gibsjose/MarbleSorter/Board.png

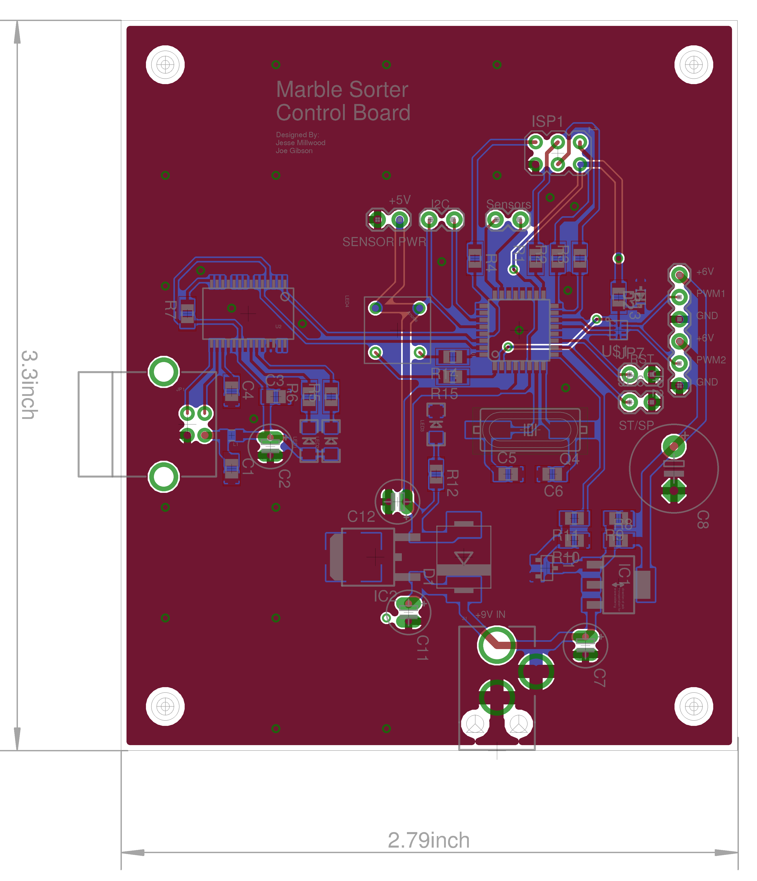
Board.png
