gibsjose/MarbleSorter/IR LED Switching.cir

$ 1 32 0.00390625 0 5 50 White 1024 1024 false

g 352 448 352 512 0
R 352 192 352 128 0 0 1 5 0 0 0.5 
r 352 192 352 256 0 10000
R 576 192 576 128 0 0 1 5 0 0 0.5 
r 576 192 576 256 0 180
w 352 256 352 320 0
w 352 320 352 384 0
w 576 288 576 256 0
162 576 384 576 448 1 1.2 1 0.1 0.1
g 576 448 576 512 0
w 576 352 576 384 0
t 512 320 576 320 0 -1 0 0 100
r 352 320 512 320 0 1000
s 352 384 352 448 0 1 true
