gibsjose/MarbleSorter/EGR 326 ATmega328P Board/EGR 326 ATmega328P Board.sch

## EAGLE design EGR 326 ATmega328P Board/EGR 326 ATmega328P Board.sch (2014-09-09)

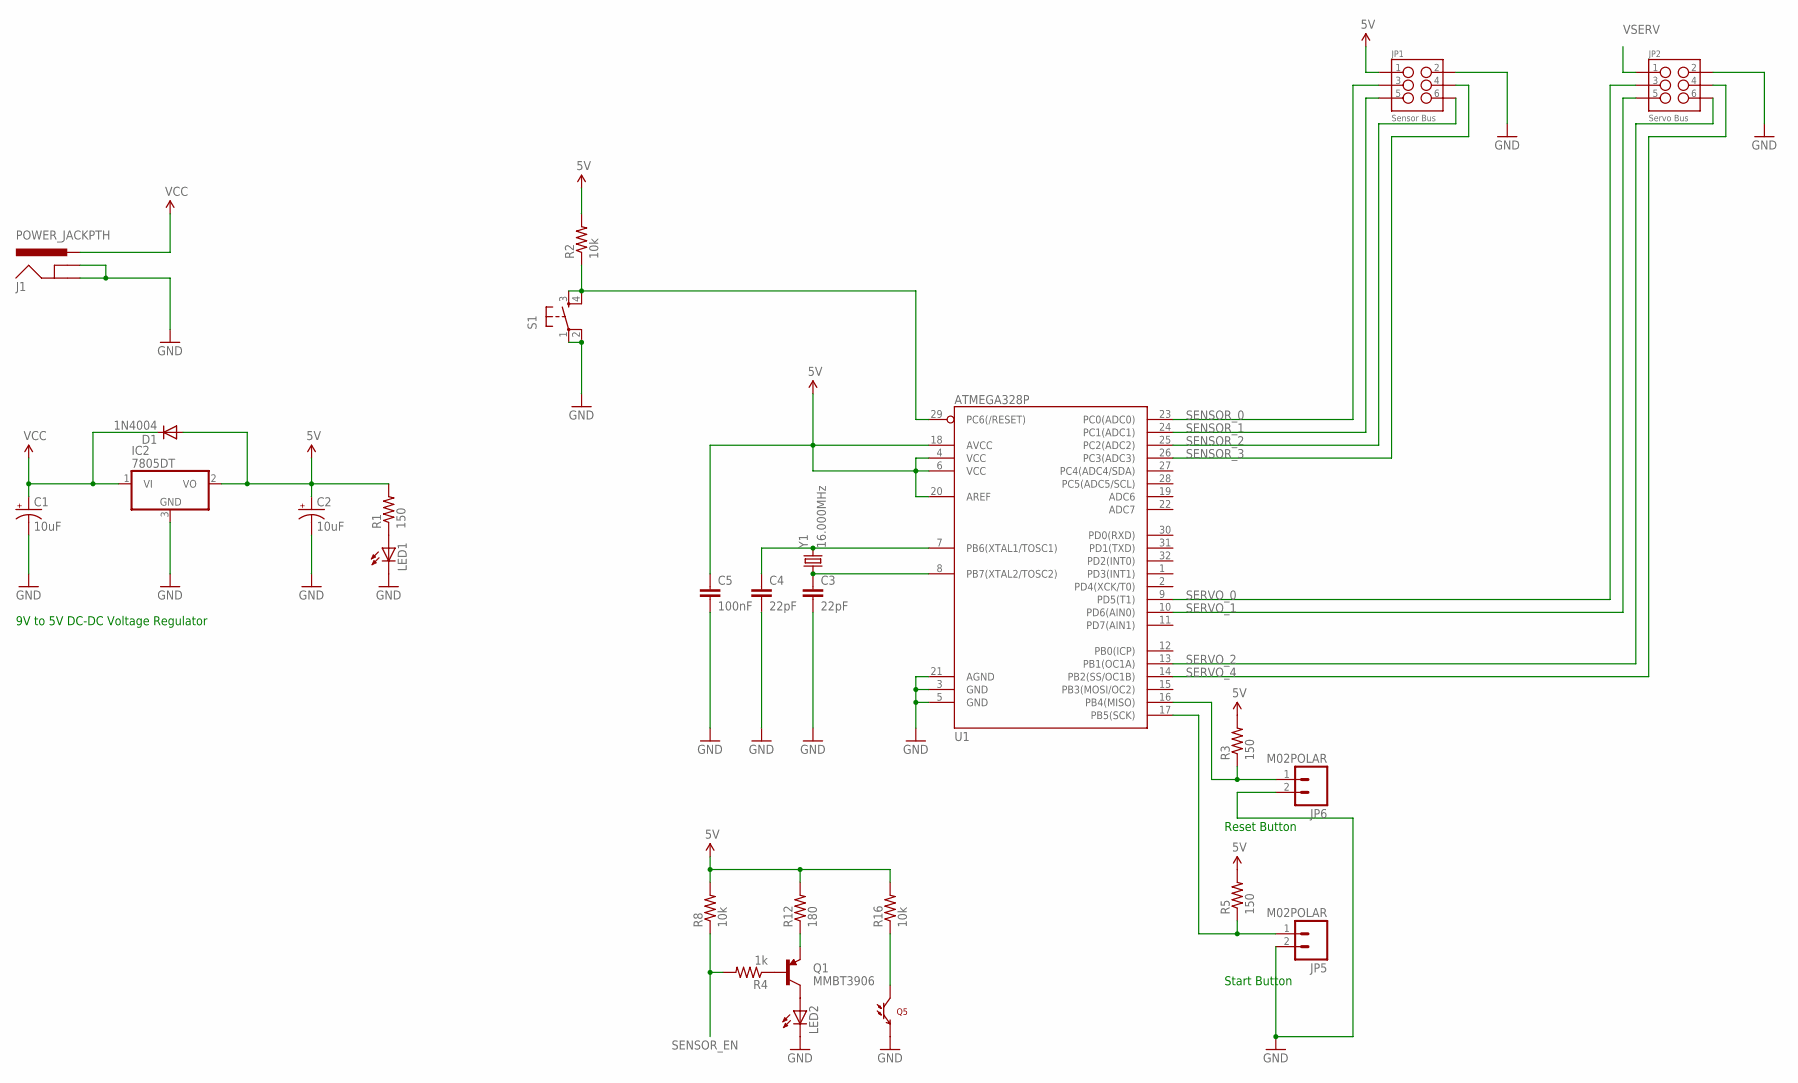
[picture p39: schematic EGR 326 ATmega328P Board.sch]

Parts:
C1, C2: 10uF; PANASONIC_D
C3, C4: 22pF; 0603-CAP
C5: 100nF; 0603-CAP
D1: 1N4004; DO41-10
IC2: 7805DT; TO252
J1: POWER_JACKPTH; POWER_JACK_PTH
JP1: Sensor Bus; 2X3-SHROUDED
JP2: Servo Bus; 2X3-SHROUDED
JP5, JP6: M02POLAR; MOLEX-1X2
LED1: LED1206; LED-1206
LED2: LED3MM
Q1: MMBT3906; SOT23
Q5: LTR-301
R1, R3, R5: 150; 0603-RES
R2, R8, R16: 10k; 0603-RES
R4: 1k; 0603-RES
R12: 180; 0603-RES
S1: TAC_SWITCHSMD; TACTILE_SWITCH_SMD
U1: ATMEGA328P; TQFP32-08
Y1: 16.000MHz; HC49UP

Connections:
5V: C2.+, C5.1, D1.A, IC2.2 (VO), JP1.1, R1.2, R2.2, R3.2, R5.2, R8.2, R12.2, R16.2, U1.4 (VCC), U1.6 (VCC), U1.18 (AVCC), U1.20 (AREF)
GND: C1.-, C2.-, C3.2, C4.2, C5.2, IC2.3 (GND), J1.GND, J1.GNDBREAK, JP1.2, JP2.2, JP5.2, JP6.2, LED1.C, LED2.K (C), Q5.E, S1.1, S1.2, U1.3 (GND), U1.5 (GND), U1.21 (AGND)
unnamed: LED1.A, R1.1
unnamed: C4.1, U1.7 (PB6(XTAL1/TOSC1)), Y1.2
unnamed: C3.1, U1.8 (PB7(XTAL2/TOSC2)), Y1.1
unnamed: Q1.1 (B), R4.1
unnamed: R2.1, S1.3, S1.4, U1.29 (PC6(/RESET))
unnamed: JP6.1, R3.1, U1.16 (PB4(MISO))
unnamed: JP5.1, R5.1, U1.17 (PB5(SCK))
unnamed: Q5.C, R16.1
unnamed: Q1.2 (E), R12.1
unnamed: LED2.A, Q1.3 (C)
SENSOR_0: JP1.3, U1.23 (PC0(ADC0))
SENSOR_1: JP1.5, U1.24 (PC1(ADC1))
SENSOR_2: JP1.6, U1.25 (PC2(ADC2))
SENSOR_3: JP1.4, U1.26 (PC3(ADC3))
SENSOR_EN: R4.2, R8.1
SERVO_0: JP2.3, U1.9 (PD5(T1))
SERVO_1: JP2.5, U1.10 (PD6(AIN0))
SERVO_2: JP2.6, U1.13 (PB1(OC1A))
SERVO_4: JP2.4, U1.14 (PB2(SS/OC1B))
VCC: C1.+, D1.C, IC2.1 (VI), J1.PWR
VSERV: JP2.1

Notes on the sheet:
9V to 5V DC-DC Voltage Regulator
Start Button
Reset Button
