gibsjose/MarbleSorter/LCD_I2C/LCD_I2C/usart.c

/*
 * usart.cpp
 *
 * Created: 07/12/2011 15:17:35
 *  Author: Boomber
 * Modified: 09/15/2013 by R. Bossemeyer to usart.c
 * changed one line to placate GCC
 *
 */ 
#include "usart.h"
#include <avr/io.h>
#include <avr/interrupt.h>
#include <avr/pgmspace.h>
#include <stdio.h>			// Conversions

void USART_Init( unsigned int ubrr)
{
/*Set baud rate */
UBRR0H = (unsigned char)(ubrr>>8);
UBRR0L = (unsigned char)ubrr;
//Enable receiver and transmitter */
UCSR0B = (1<<RXEN0)|(1<<TXEN0);
/* Set frame format: 8data, 2stop bit */
UCSR0C = (1<<USBS0)|(3<<UCSZ00);
}




void USART_Sendbyte( unsigned char data )
{
/* Wait for empty transmit buffer */
while ( !( UCSR0A & (1<<UDRE0)) )
;
/* Put data into buffer, sends the data */
//UDR0 = char(data);
UDR0 = data;
}

void USART_Send_string(const char *str)
{

	  while (*str) 
      USART_Sendbyte(*str++);
	
}

void USART_Send_int(unsigned int d )
{
	char str[10];
	sprintf(str,"%u",d);
	USART_Send_string(str);
	
}



unsigned char USART_Receive( void )
{
/* Wait for data to be received */
while ( !(UCSR0A & (1<<RXC0)) )
;
/* Get and return received data from buffer */
return UDR0;
}
