gibsjose/MarbleSorter/LCD_I2C/LCD_I2C/usart.h

/*
 * usart.h
 *
 * Created: 07/12/2011 15:16:27
 *  Author: Boomber
 */ 


#ifndef USART_H_
#define USART_H_


#define FOSC 16000000 // Clock Speed
#define BAUD 9600	  // Baud Rate
#define MYUBRR (((((FOSC * 10) / (16L * BAUD)) + 5) / 10) - 1)

void USART_Init( unsigned int ubrr);

void USART_Sendbyte( unsigned char data );
void USART_Send_string(const char *str);
void USART_Send_int(unsigned int d);

unsigned char USART_Receive( void );


#endif /* USART_H_ */
